SevRyb/Programmable-IR-Remote-Control/Function-Diagram.pdf

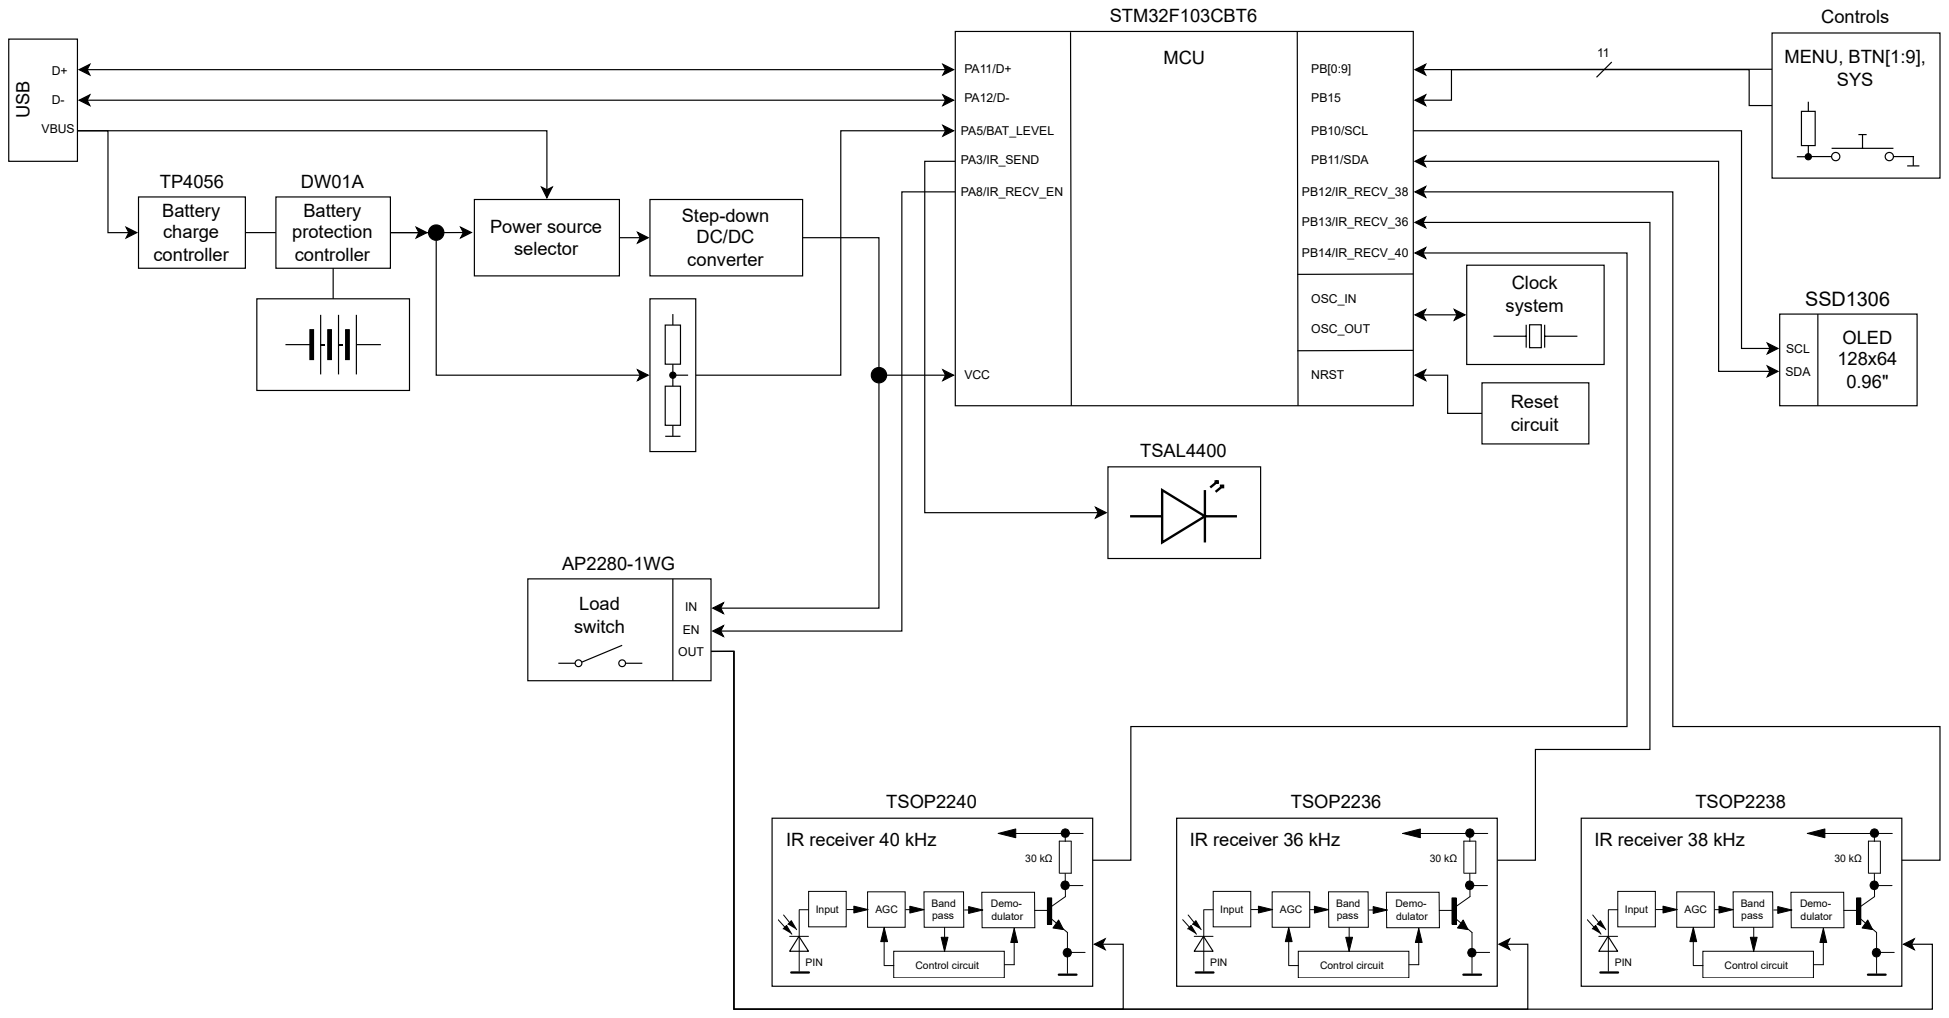
[picture p6: page 1]
USB; Power source selector; TSAL4400; Demo-; pass; Input; AGC; PIN; Band; dulator; Control circuit; TSOP2240; TSOP2236; TSOP2238; SSD1306; SCL; SDA; OLED 128x64 0.96"; Battery charge controller; Battery protection controller; MENU, BTN[1:9], SYS; Controls; Step-down DC/DC converter; MCU; STM32F103CBT6; VBUS; PA5/BAT_LEVEL; PA3/IR_SEND; PA8/IR_RECV_EN; PB10/SCL; PB11/SDA; PB12/IR_RECV_38; PB13/IR_RECV_36; PB14/IR_RECV_40; OSC_IN; OSC_OUT; NRST; Reset circuit; VCC; Clock system; Load switch; OUT

IR receiver 40 kHz

IR receiver 36 kHz

IR receiver 38 kHz
