SevRyb/Programmable-IR-Remote-Control/Structure-Diagram.pdf

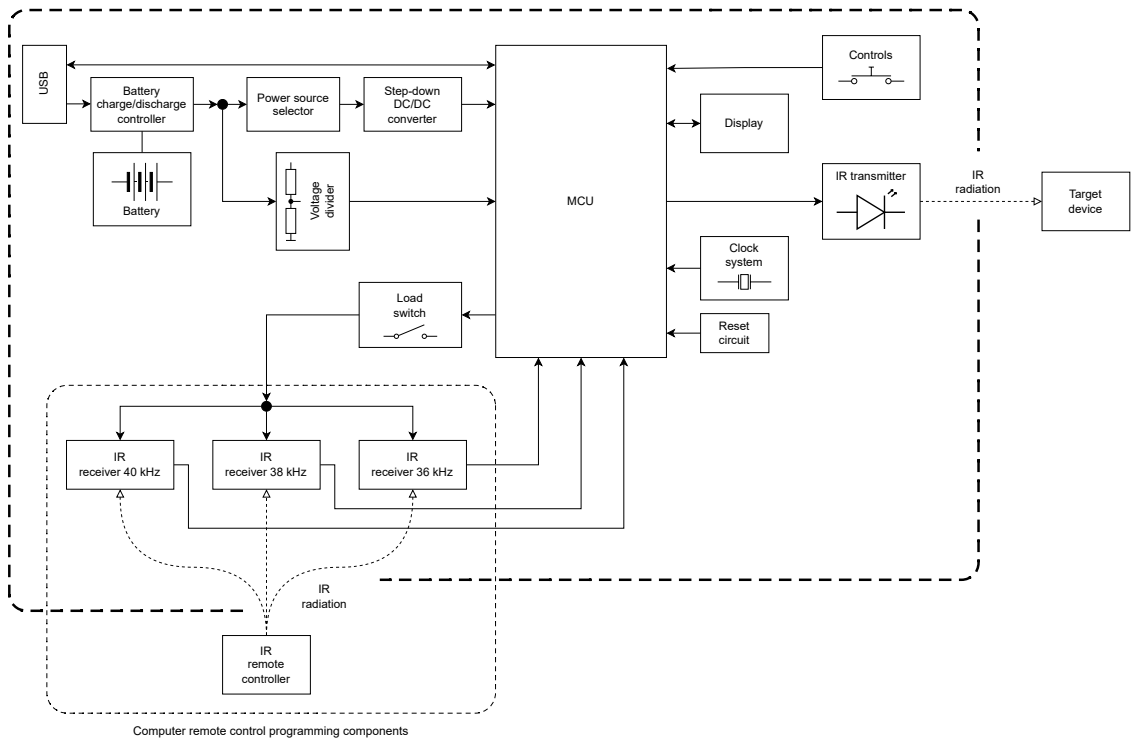
[picture p7: page 1]
MCU; Power source selector; Reset circuit; Clock system; Battery charge/discharge; controller; Display; USB; Load switch; IR receiver 40 kHz; IR receiver 38 kHz; IR receiver 36 kHz; Step-down DC/DC converter; IR remote controller; Target device; IR radiation; Battery; IR transmitter; Controls; Voltage; divider

Computer remote control programming components
