SevRyb/Programmable-IR-Remote-Control/Circuit-Diagram.pdf

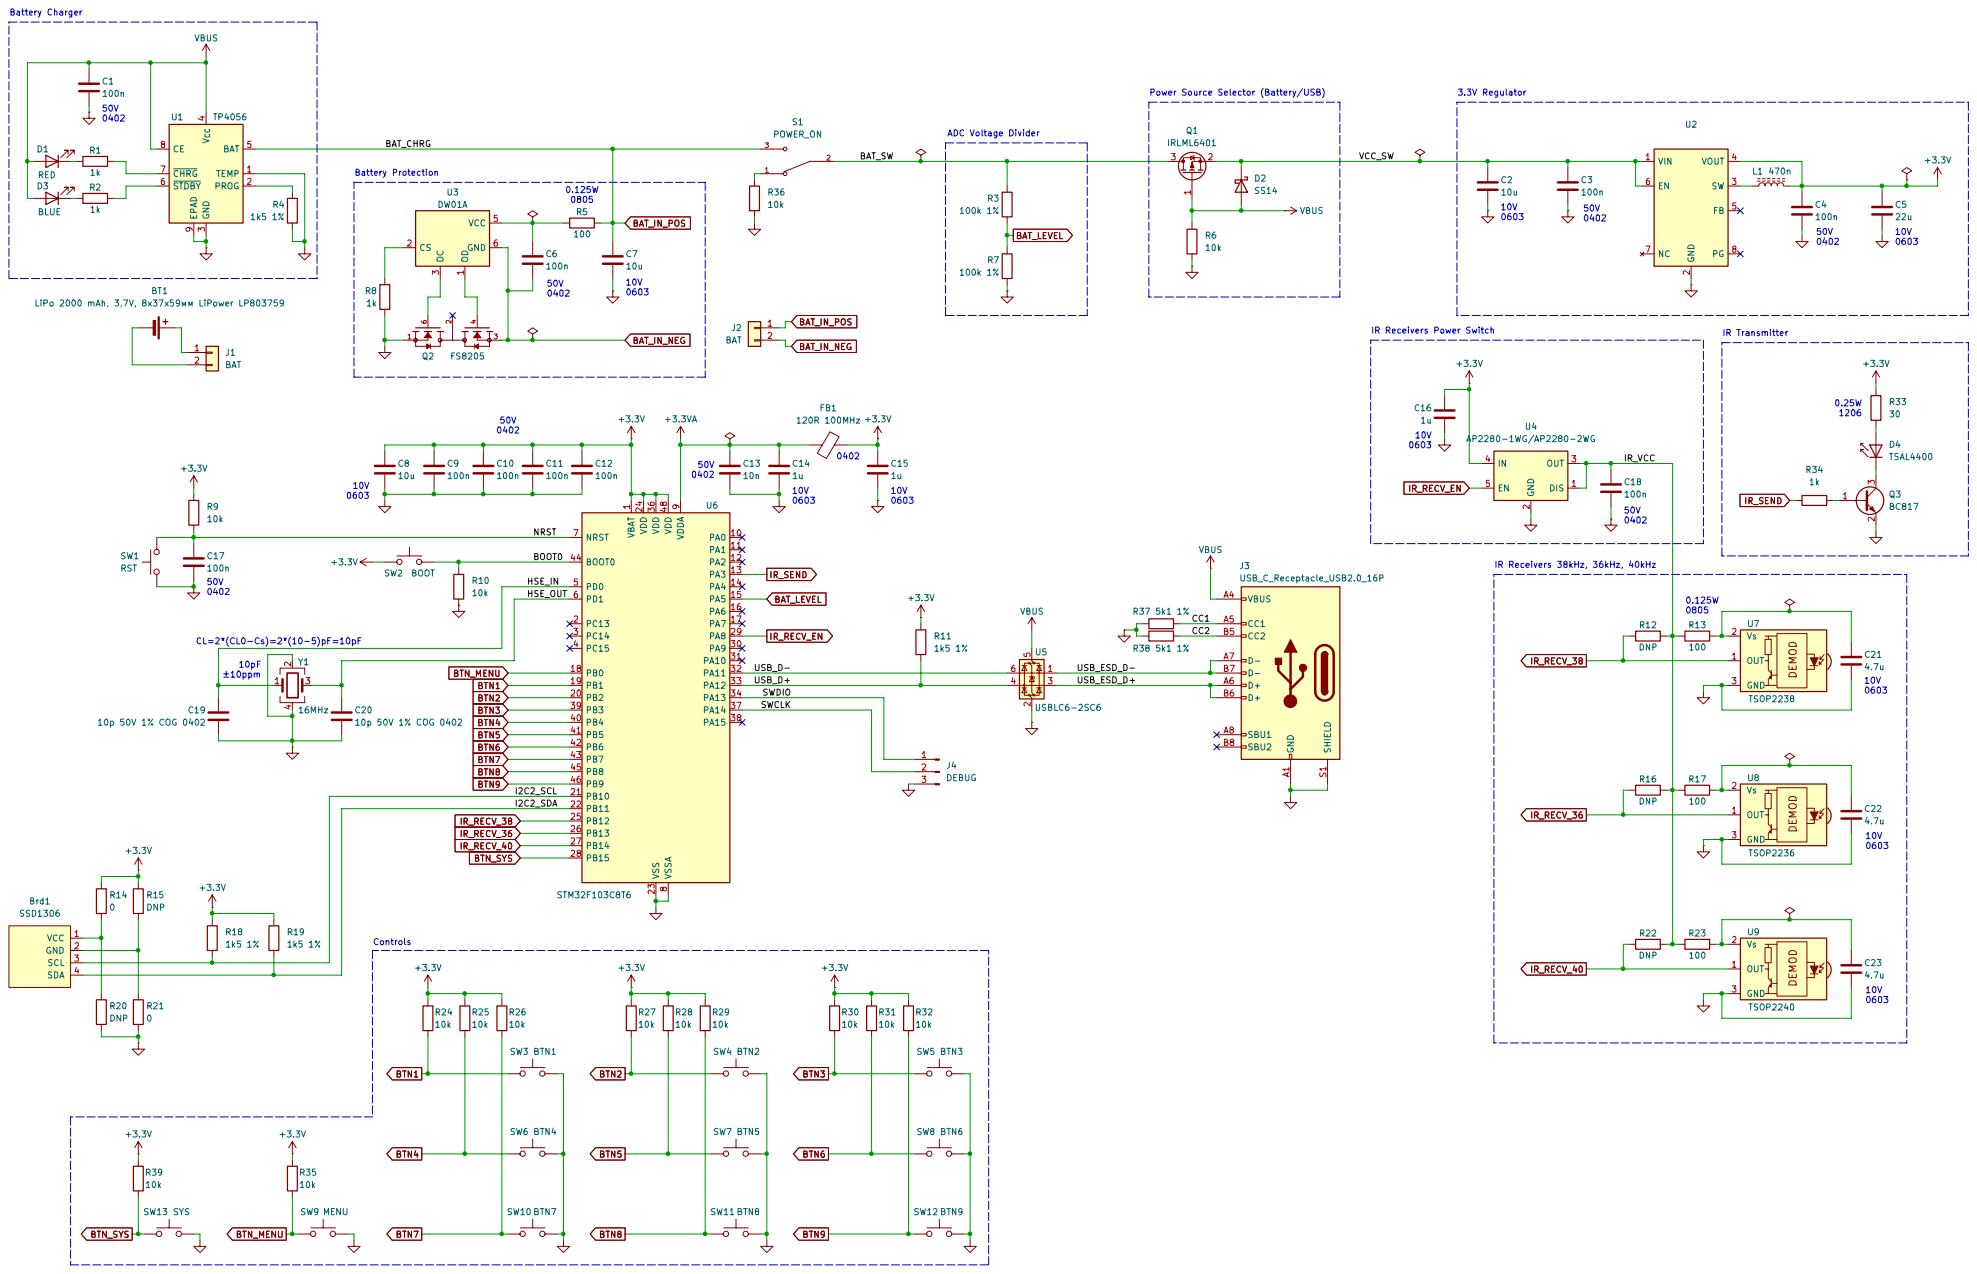
[picture p8: page 1]
