SevRyb/Programmable-IR-Remote-Control/firmware/Core/Inc/main.h

#define IR_SEND_Pin GPIO_PIN_3
#define IR_SEND_GPIO_Port GPIOA
#define BAT_LEVEL_Pin GPIO_PIN_5
#define BAT_LEVEL_GPIO_Port GPIOA
#define BTN_MENU_Pin GPIO_PIN_0
#define BTN_MENU_GPIO_Port GPIOB
#define BTN_MENU_EXTI_IRQn EXTI0_IRQn
#define BTN1_Pin GPIO_PIN_1
#define BTN1_GPIO_Port GPIOB
#define BTN1_EXTI_IRQn EXTI1_IRQn
#define BTN2_Pin GPIO_PIN_2
#define BTN2_GPIO_Port GPIOB
#define BTN2_EXTI_IRQn EXTI2_IRQn
#define IR_RECV_38_Pin GPIO_PIN_12
#define IR_RECV_38_GPIO_Port GPIOB
#define IR_RECV_36_Pin GPIO_PIN_13
#define IR_RECV_36_GPIO_Port GPIOB
#define IR_RECV_40_Pin GPIO_PIN_14
#define IR_RECV_40_GPIO_Port GPIOB
#define BTN_SYS_Pin GPIO_PIN_15
#define BTN_SYS_GPIO_Port GPIOB
#define BTN_SYS_EXTI_IRQn EXTI15_10_IRQn
#define IR_RECV_EN_Pin GPIO_PIN_8
#define IR_RECV_EN_GPIO_Port GPIOA
#define BTN3_Pin GPIO_PIN_3
#define BTN3_GPIO_Port GPIOB
#define BTN3_EXTI_IRQn EXTI3_IRQn
#define BTN4_Pin GPIO_PIN_4
#define BTN4_GPIO_Port GPIOB
#define BTN4_EXTI_IRQn EXTI4_IRQn
#define BTN5_Pin GPIO_PIN_5
#define BTN5_GPIO_Port GPIOB
#define BTN5_EXTI_IRQn EXTI9_5_IRQn
#define BTN6_Pin GPIO_PIN_6
#define BTN6_GPIO_Port GPIOB
#define BTN6_EXTI_IRQn EXTI9_5_IRQn
#define BTN7_Pin GPIO_PIN_7
#define BTN7_GPIO_Port GPIOB
#define BTN7_EXTI_IRQn EXTI9_5_IRQn
#define BTN8_Pin GPIO_PIN_8
#define BTN8_GPIO_Port GPIOB
#define BTN8_EXTI_IRQn EXTI9_5_IRQn
#define BTN9_Pin GPIO_PIN_9
#define BTN9_GPIO_Port GPIOB
#define BTN9_EXTI_IRQn EXTI9_5_IRQn
#define IRMP_Receive_GPIO_Port IR_RECV_38_GPIO_Port
#define IRMP_Receive_Pin IR_RECV_38_Pin
#define IRSND_Transmit_GPIO_Port IR_SEND_GPIO_Port
#define IRSND_Transmit_Pin IR_SEND_Pin
