SevRyb/Programmable-IR-Remote-Control/(notices)

Notices in the files:
firmware/Core/Src/main.c:
Copyright (c) 2025 STMicroelectronics.
All rights reserved.
This software is licensed under terms that can be found in the LICENSE file
